rigexpert/Tokenblauser/README.md

# Tokenblauser

Source code for the RigExpert Tokenblauser GPSDO.

The firmware is released under GPL and can be compiled by using Arduino IDE.

Bootloader: samd21_sam_ba.bin from the SAMD package.

See notes in the Tokenblauser.ino file.

Binary files to update the firmware: https://github.com/rigexpert/Tokenblauser/releases/

## Key features:

Four independent outputs, 0.16 to 200 MHz. Up to 350 or 710 MHz, depending on the type of the PLL chip.

One auxilary output, 10 MHz (sqare wave).

Carrier-to-noise ratio display for GPS/Galileo satellites.
