rigexpert/Tokenblauser/APPNOTES/README.md

# Application notes

TBR-AN-1: Receiving FT-8 at 10 GHz via the QO-100 satellite

TBR-AN-2: Receiving 10 GHz beacons from geostationary and LEO satellites

TBR-AN-3: Description of the schematic diagram and DIY hardware modifications

TBR-AN-5: What’s wrong with the QO-100 WebSDRs?

TBR-AN-6: Frequency stability measurement using a satellite beacon at 11.703505 GHz, GNU Radio and TimeLab
tbr-an-6-01.grc - GRC fole for this application note.

TBR-AN-7: A GSDO as an external 28.8 MHz reference clock for RTL-SDR
