rigexpert/Tokenblauser/SCHEMATICS/PCB_1.1/TokenBlauser.MB.pdf

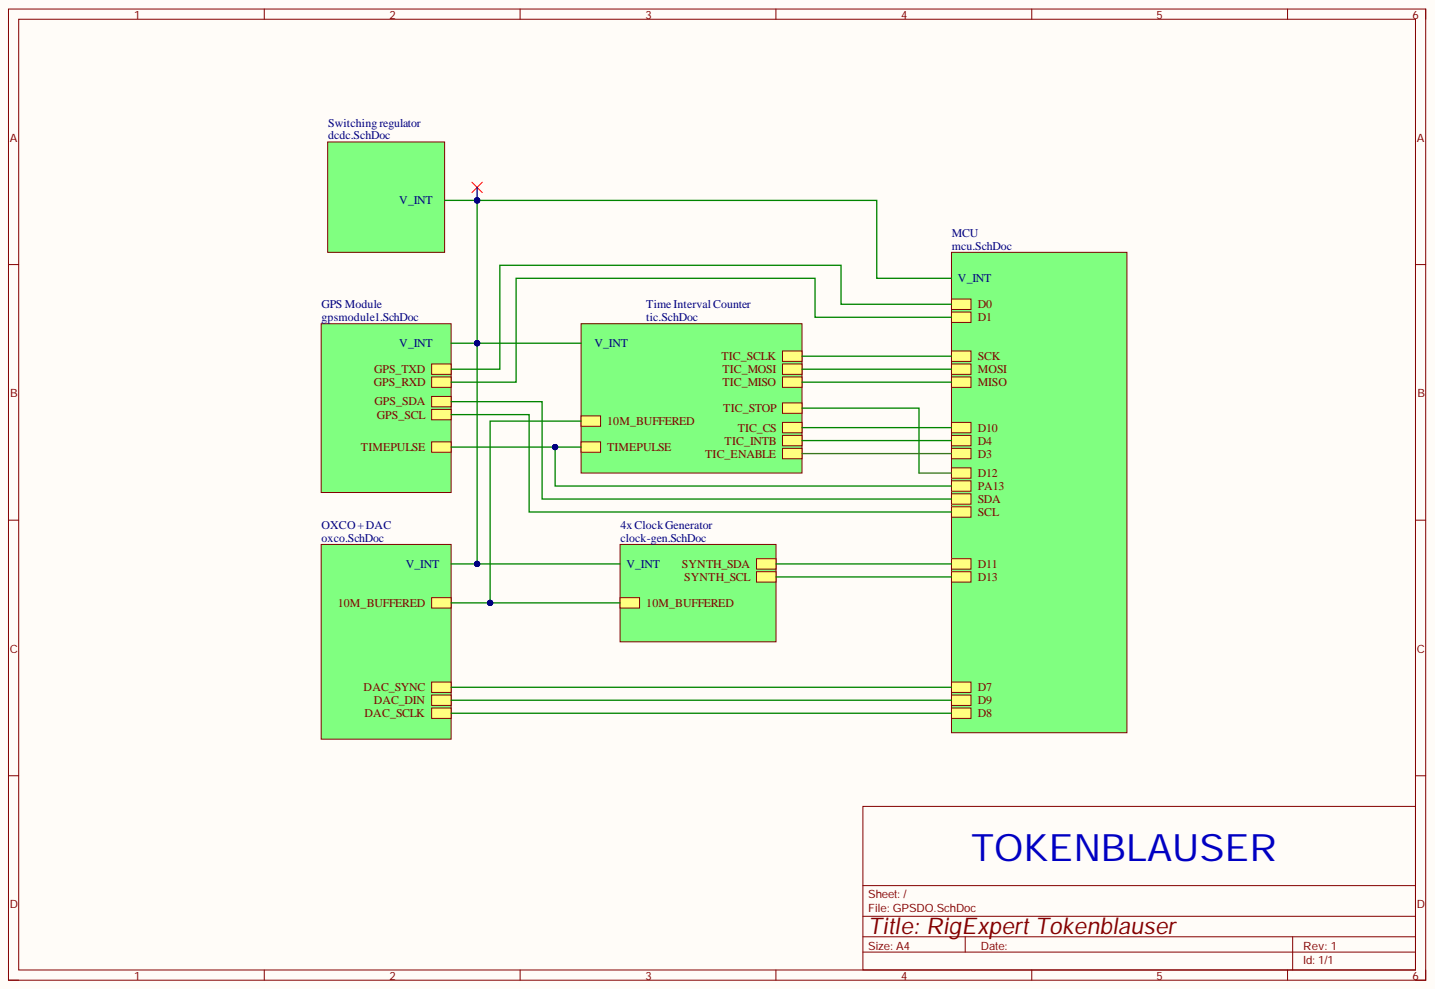
[picture p1: page 1]

Size: A4 | Date: | Rev: 1

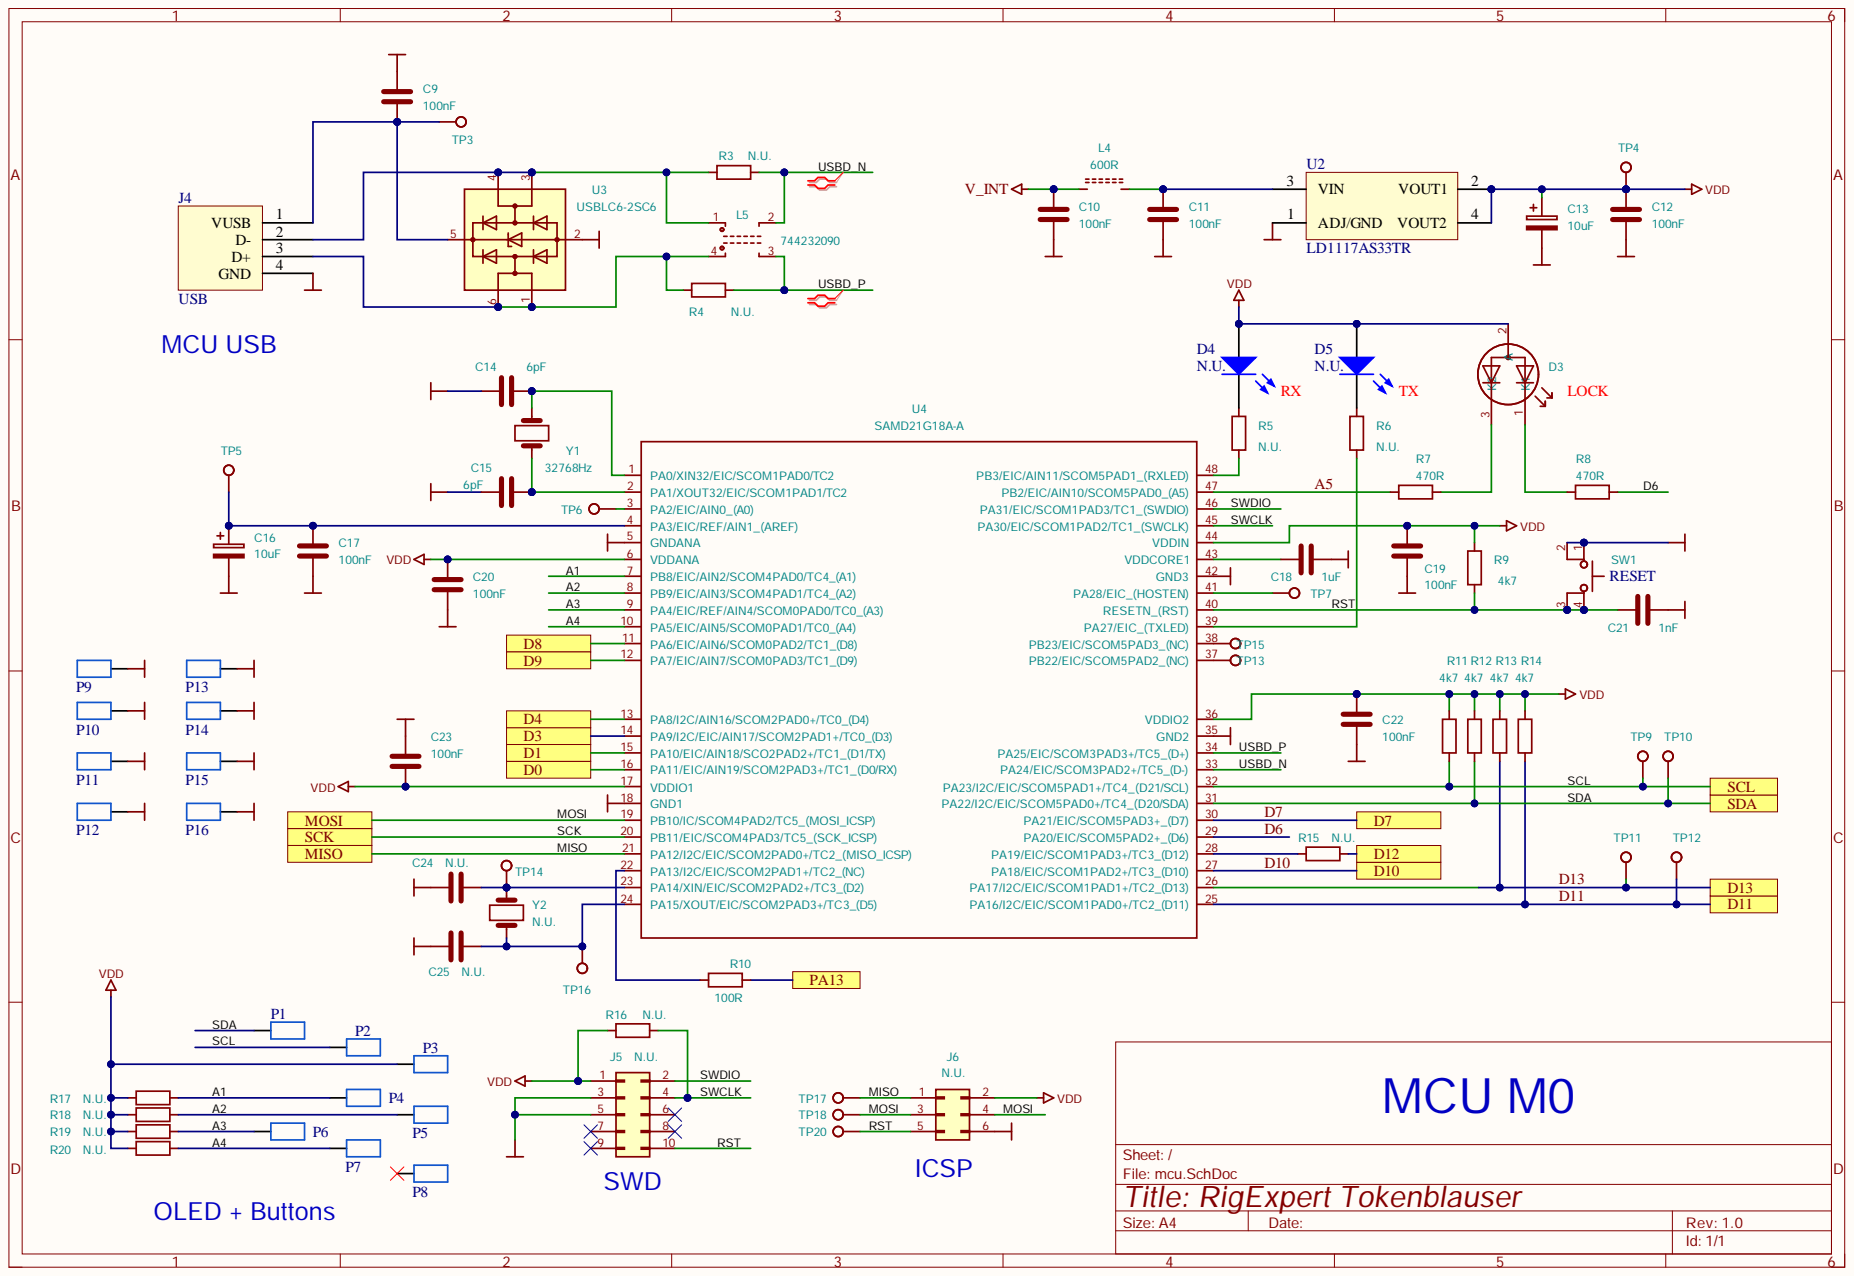
[picture p2: page 2]

PB10/IC/SCOM4PAD2/TC5_(MOSI_ICSP) 19 GND1 18 VDDIO1 17 | | SDA

PA15/XOUT/EIC/SCOM2PAD3+/TC3_(D5) 24 PA14/XIN/EIC/SCOM2PAD2+/TC3_(D2) 23 PA13/I2C/EIC/SCOM2PAD1+/TC2_(NC) 22

5 | 6 RST

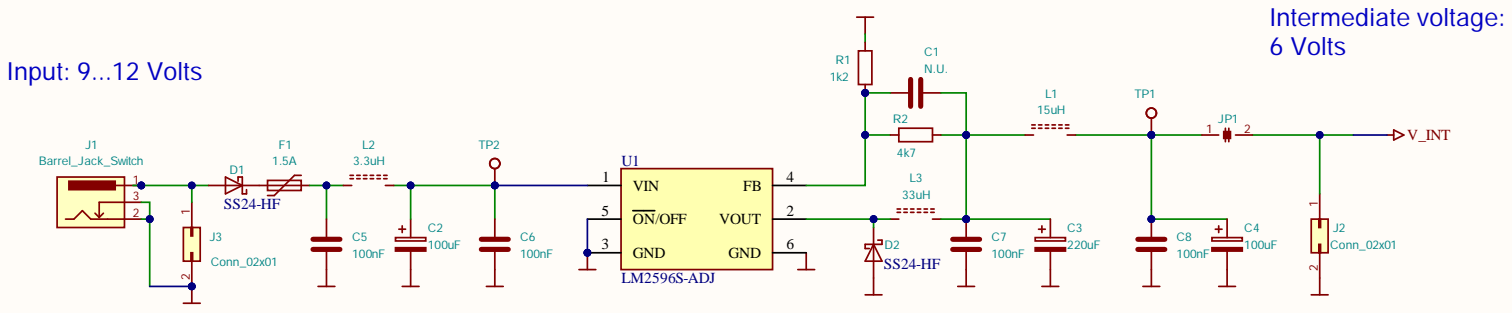
[picture p3: page 3]

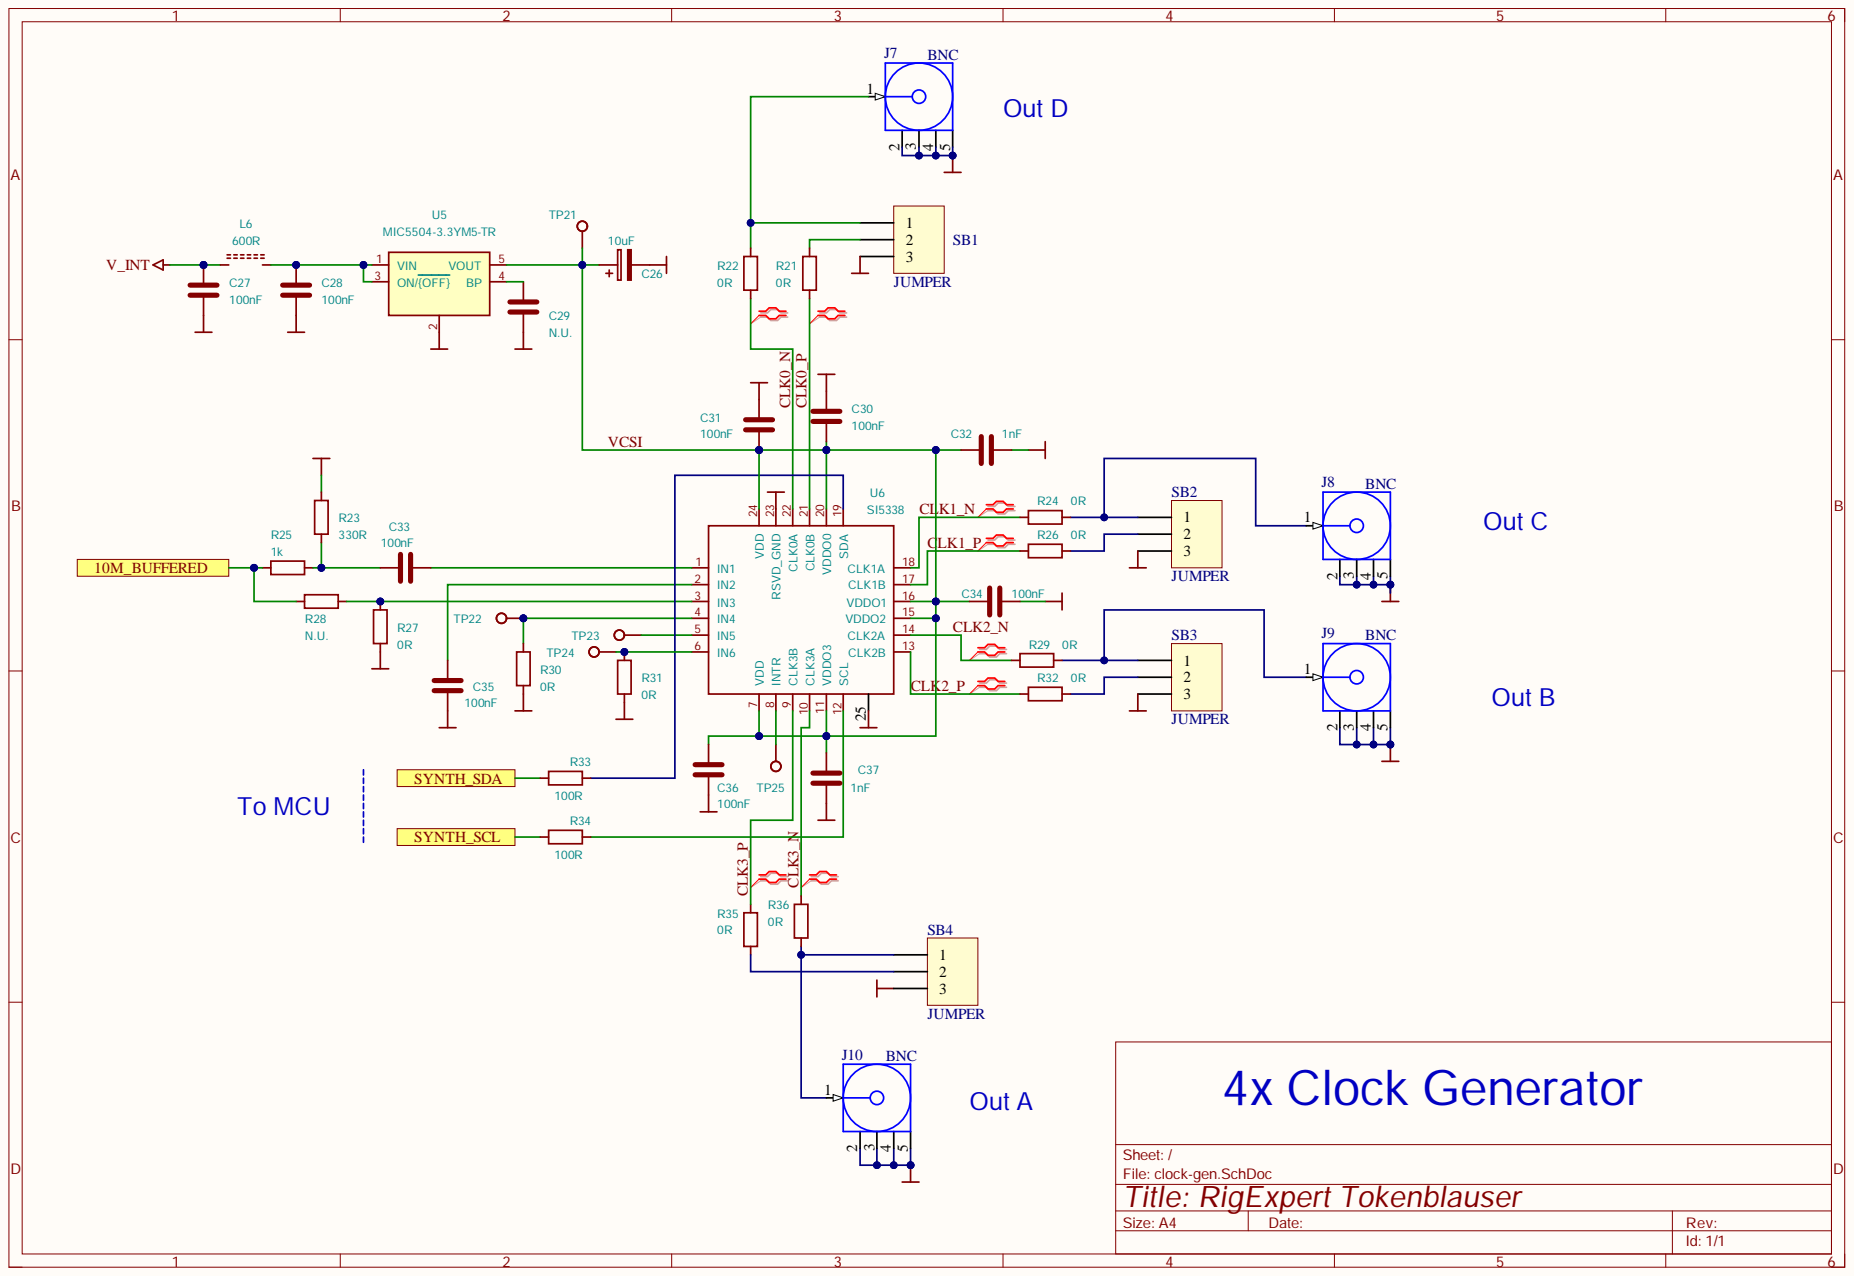
[picture p4: page 4]

IN2 2
IN3 3
IN4 4 IN5 5

Sheet: /
File: clock-gen.SchDoc
Title: RigExpert Tokenblauser

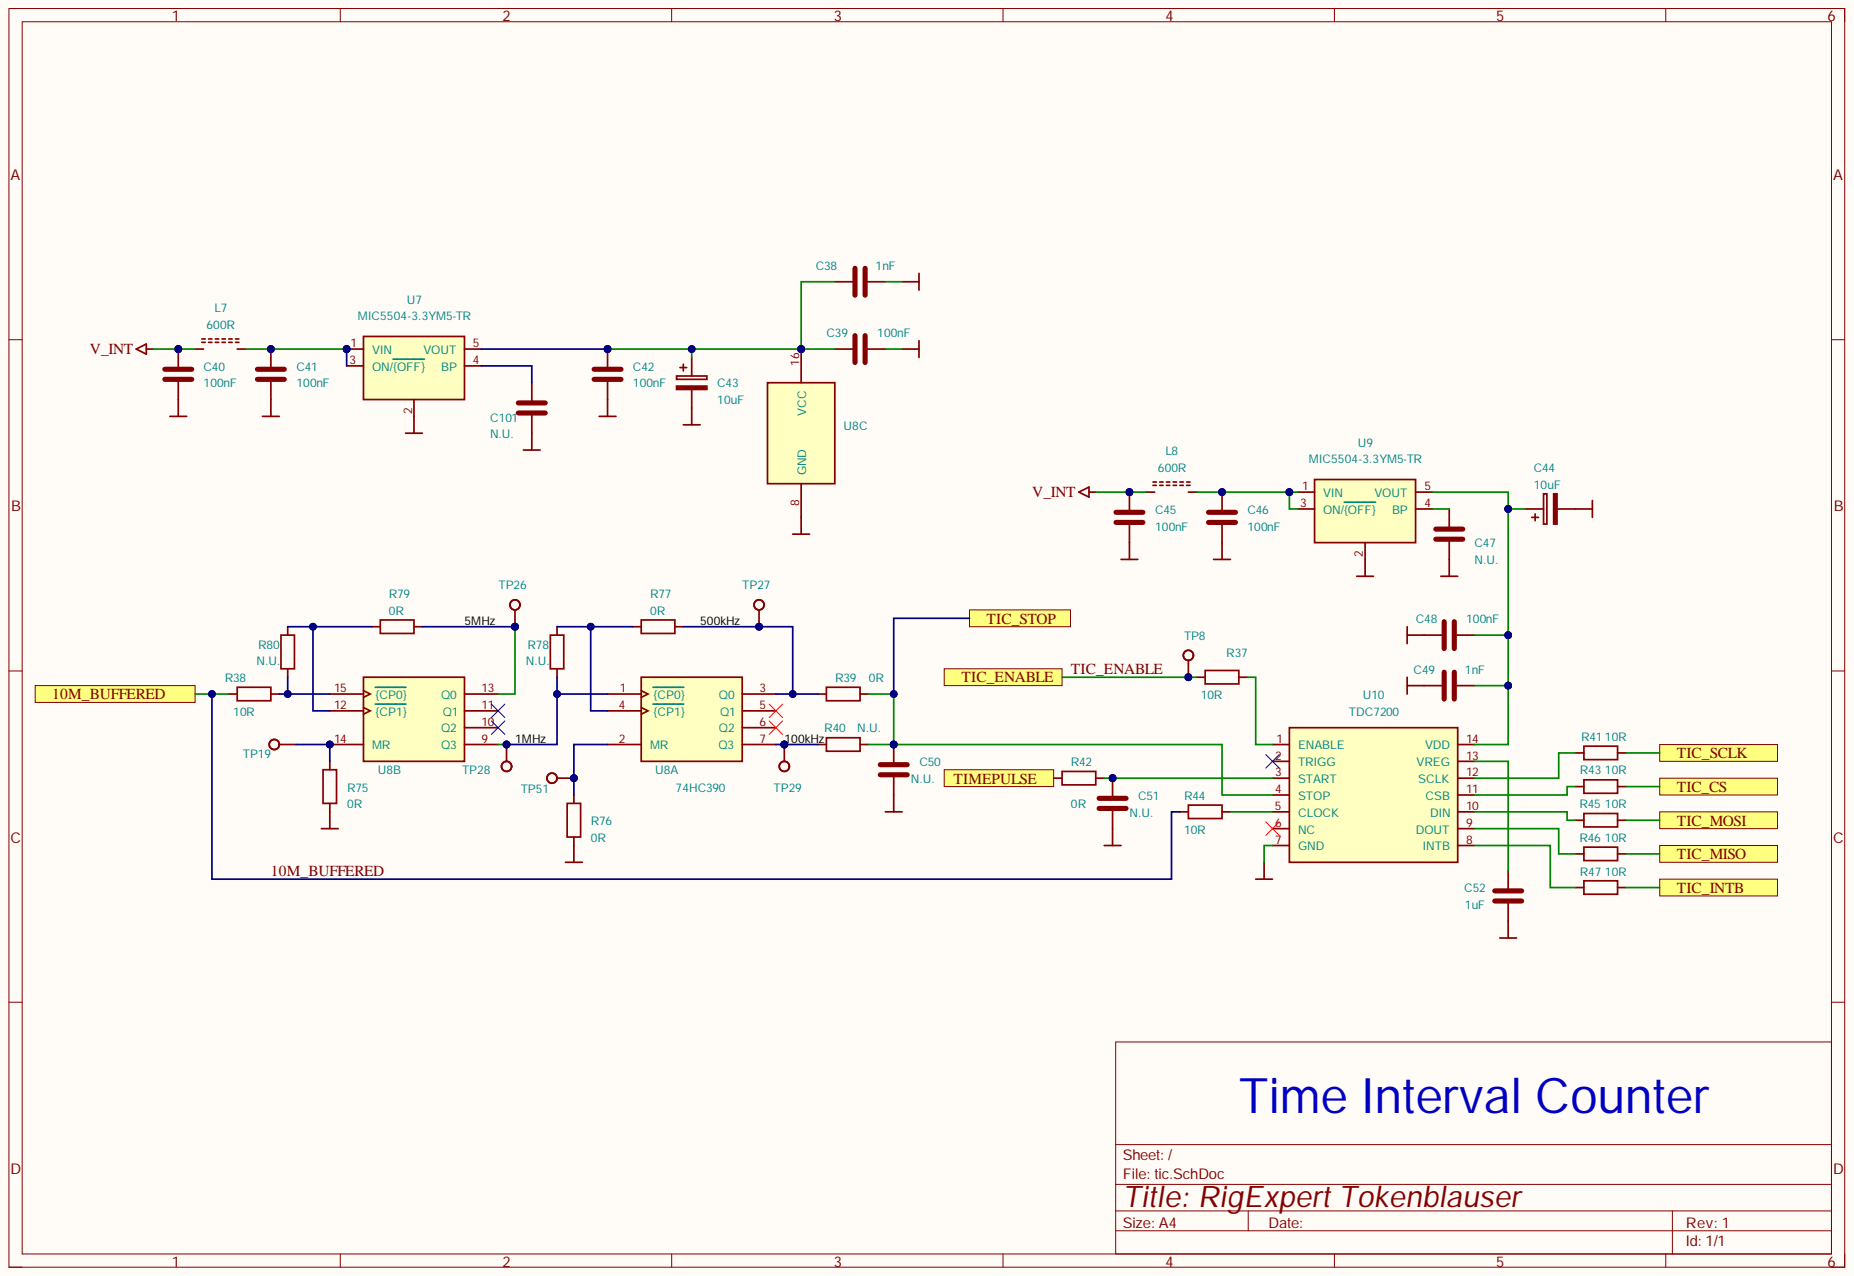
[picture p5: page 5]

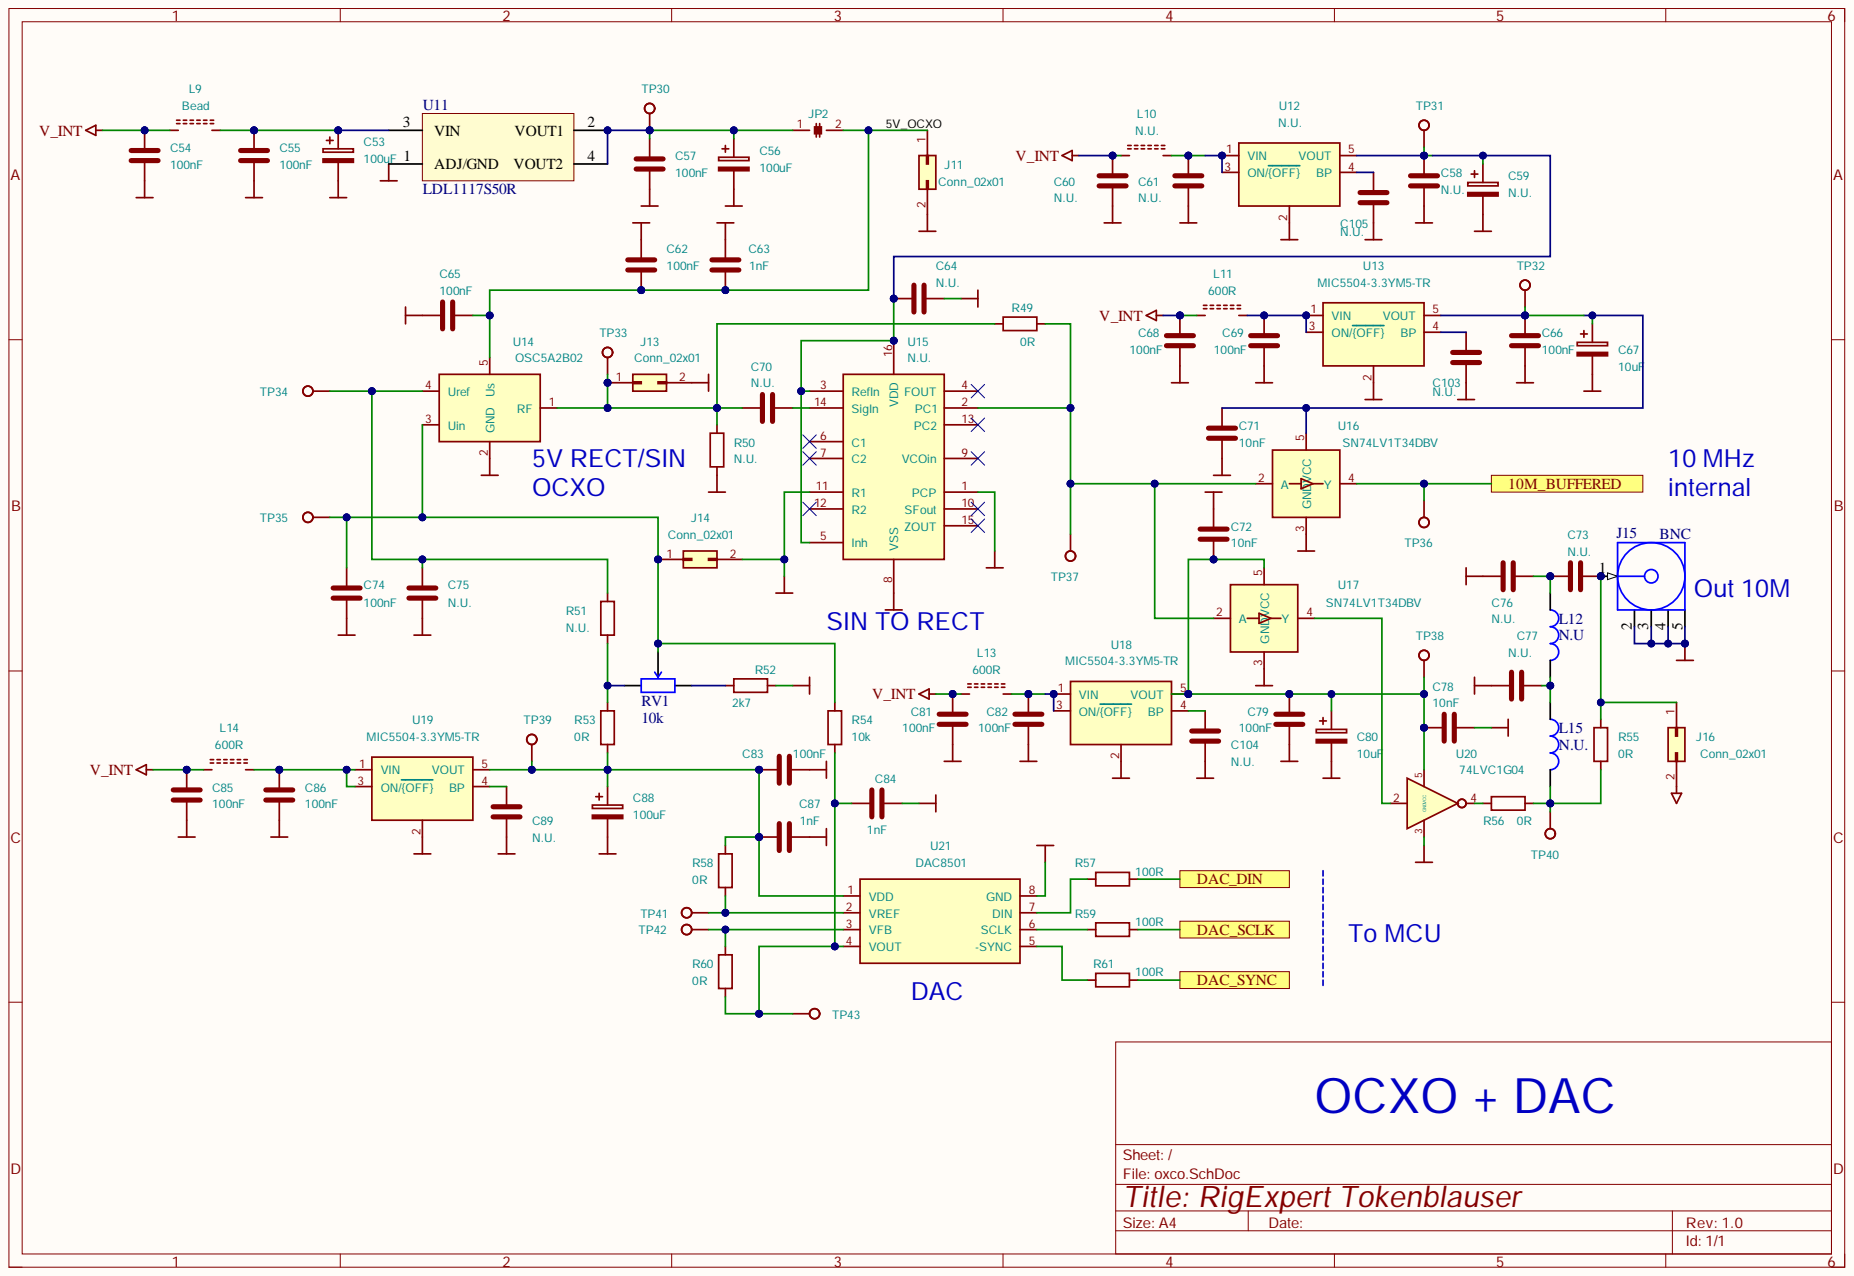
[picture p6: page 6]

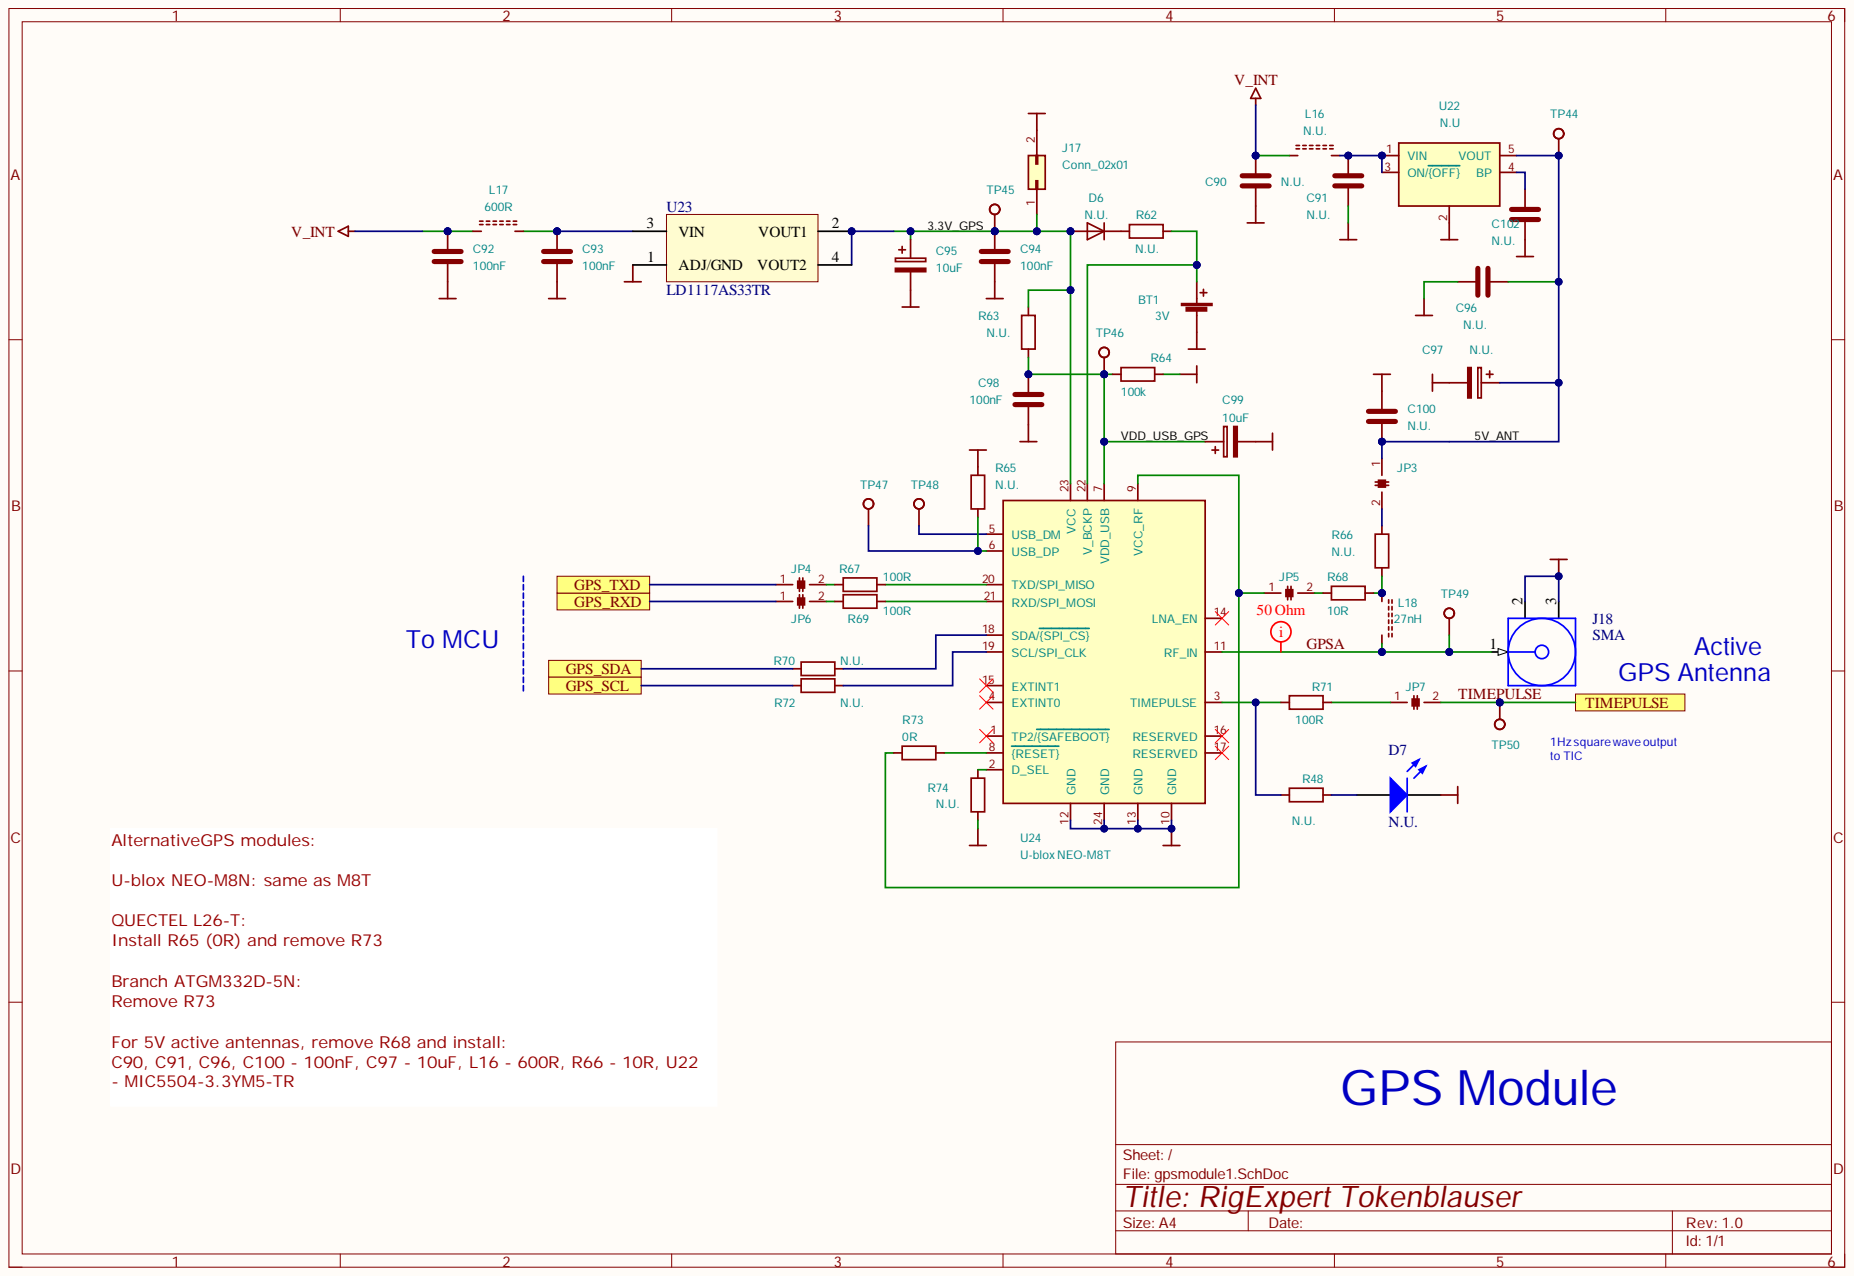
[picture p7: page 7]

U-blox NEO-M8N: same as M8T

For 5V active antennas, remove R68 and install:
- MIC5504-3.3YM5-TR
