rigexpert/Tokenblauser/SCHEMATICS/PCB_1.1/TokenBllauser.KB.pdf

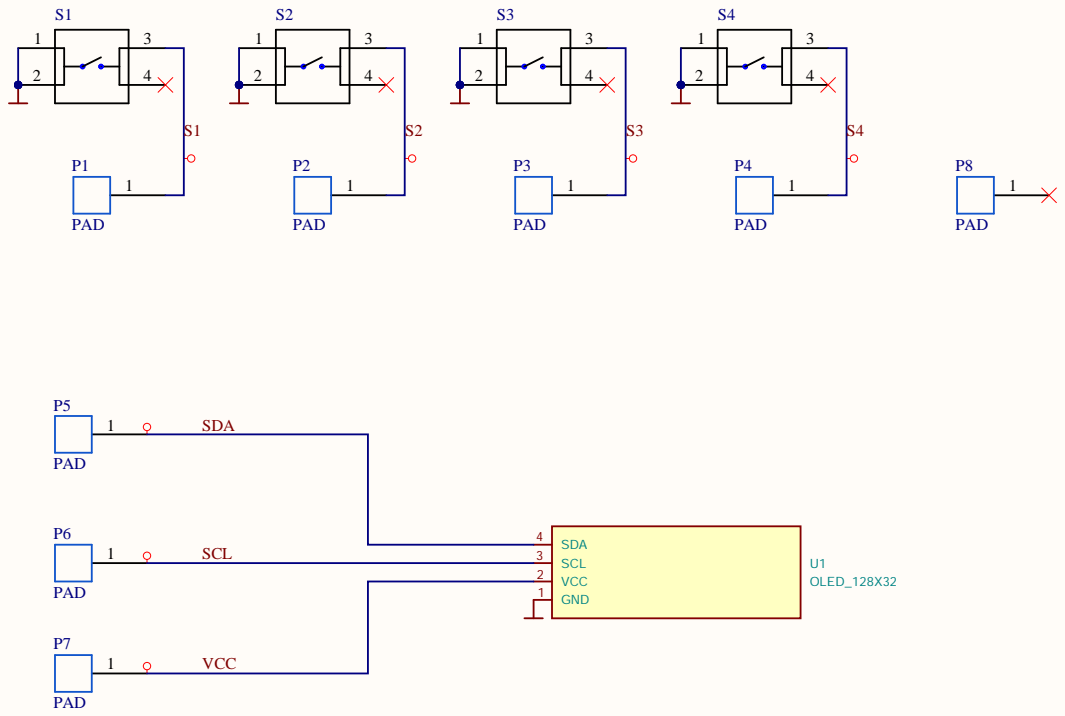
[picture p8: page 1]
