rigexpert/Tokenblauser/Si5338-RevB-Registers-1.h

//Register map for use with AN428 (JumpStart)
//http://www.skyworksinc.com/timing
//#BEGIN_HEADER
//Date = Friday, July 29, 2022 3:02 PM
//File version = 3
//Software Name = ClockBuilder Pro
//Software version = 4.0.0.0
//Software date = 7 26, 2021
//Chip = Si533x
//Part Number = Si533x
//#END_HEADER
//Input Frequency (MHz) = 10.000000000
//Input Type = LVDS_LVPECL_HCSL
//P1 = 1
//Input Mux = RefClk
//FDBK Input Frequency (MHz) = 10.000000000
//FDBK Input Type = OFF
//P2 = 1
//FDBK Mux = NoClk
//PFD Input Frequency (MHz) = 10.000000000
//VCO Frequency (GHz) = 2.400000
//N = 240  (240.0000)
//Internal feedback enabled
//Output Clock 0
// Output Frequency (MHz) = 40.000000000
// Mux Selection = IDn
// MultiSynth = 60  (60.0000)
// R = 1
//Output Clock 1
// Output Frequency (MHz) = 28.800000000
// Mux Selection = IDn
// MultiSynth = 83  1/3  (83.3333)
// R = 1
//Output Clock 2
// Output Frequency (MHz) = 25.000000000
// Mux Selection = IDn
// MultiSynth = 96  (96.0000)
// R = 1
//Output Clock 3
// Output Frequency (MHz) = 24.000000000
// Mux Selection = IDn
// MultiSynth = 100  (100.0000)
// R = 1
//Driver 0
// Enabled
// Powered on
// Output voltage = 3.30
// Output type = 3.3V CMOS on A and B
// Output state when disabled = AlwaysOn
//Driver 1
// Enabled
// Powered on
// Output voltage = 3.30
// Output type = 3.3V CMOS on A and B
// Output state when disabled = AlwaysOn
//Driver 2
// Enabled
// Powered on
// Output voltage = 3.30
// Output type = 3.3V CMOS on A and B
// Output state when disabled = AlwaysOn
//Driver 3
// Enabled
// Powered on
// Output voltage = 3.30
// Output type = 3.3V CMOS on A and B
// Output state when disabled = AlwaysOn
//Clock 0 phase inc/dec step size (ns) = 0.000
//Clock 1 phase inc/dec step size (ns) = 0.000
//Clock 2 phase inc/dec step size (ns) = 0.000
//Clock 3 phase inc/dec step size (ns) = 0.000
//Phase increment and decrement pin control is off
//Frequency increment and decrement pin control is off
//Frequency increment and decrement is disabled
//Initial phase offset 0 (ns) = 0.000
//Initial phase offset 1 (ns) = 0.000
//Initial phase offset 2 (ns) = 0.000
//Initial phase offset 3 (ns) = 0.000
//SSC is disabled

#define NUM_REGS_MAX 350

typedef struct Reg_Data{
   unsigned char Reg_Addr;
   unsigned char Reg_Val;
   unsigned char Reg_Mask;
} Reg_Data;

Reg_Data const code Reg_Store[NUM_REGS_MAX] = {
{  0,0x00,0x00},
{  1,0x00,0x00},
{  2,0x00,0x00},
{  3,0x00,0x00},
{  4,0x00,0x00},
{  5,0x00,0x00},
{  6,0x08,0x1D},
{  7,0x00,0x00},
{  8,0x70,0x00},
{  9,0x0F,0x00},
{ 10,0x00,0x00},
{ 11,0x00,0x00},
{ 12,0x00,0x00},
{ 13,0x00,0x00},
{ 14,0x00,0x00},
{ 15,0x00,0x00},
{ 16,0x00,0x00},
{ 17,0x00,0x00},
{ 18,0x00,0x00},
{ 19,0x00,0x00},
{ 20,0x00,0x00},
{ 21,0x00,0x00},
{ 22,0x00,0x00},
{ 23,0x00,0x00},
{ 24,0x00,0x00},
{ 25,0x00,0x00},
{ 26,0x00,0x00},
{ 27,0x70,0x80},
{ 28,0x03,0xFF},
{ 29,0x00,0xFF},
{ 30,0xB0,0xFF},
{ 31,0xC0,0xFF},
{ 32,0xC0,0xFF},
{ 33,0xC0,0xFF},
{ 34,0xC0,0xFF},
{ 35,0x00,0xFF},
{ 36,0x03,0x1F},
{ 37,0x03,0x1F},
{ 38,0x03,0x1F},
{ 39,0x03,0x1F},
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
{255, 1, 0xFF}, // set page bit to 1 
{  0,0x00,0x00},
{  1,0x00,0x00},
{  2,0x00,0x00},
{  3,0x00,0x00},
{  4,0x00,0x00},
{  5,0x00,0x00},
{  6,0x00,0x00},
{  7,0x00,0x00},
{  8,0x00,0x00},
{  9,0x00,0x00},
{ 10,0x00,0x00},
{ 11,0x00,0x00},
{ 12,0x00,0x00},
{ 13,0x00,0x00},
{ 14,0x00,0x00},
{ 15,0x00,0x00},
{ 16,0x00,0x00},
{ 17,0x01,0x00},
{ 18,0x00,0x00},
{ 19,0x00,0x00},
{ 20,0x90,0x00},
{ 21,0x31,0x00},
{ 22,0x00,0x00},
{ 23,0x00,0x00},
{ 24,0x01,0x00},
{ 25,0x00,0x00},
{ 26,0x00,0x00},
{ 27,0x00,0x00},
{ 28,0x00,0x00},
{ 29,0x00,0x00},
{ 30,0x00,0x00},
{ 31,0x00,0xFF},
{ 32,0x00,0xFF},
{ 33,0x01,0xFF},
{ 34,0x00,0xFF},
{ 35,0x00,0xFF},
{ 36,0x90,0xFF},
{ 37,0x31,0xFF},
{ 38,0x00,0xFF},
{ 39,0x00,0xFF},
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
{255, 0, 0xFF} }; // set page bit to 0
//End of file
